TheStarsBlessing/TD4-CPU/原理图.pdf

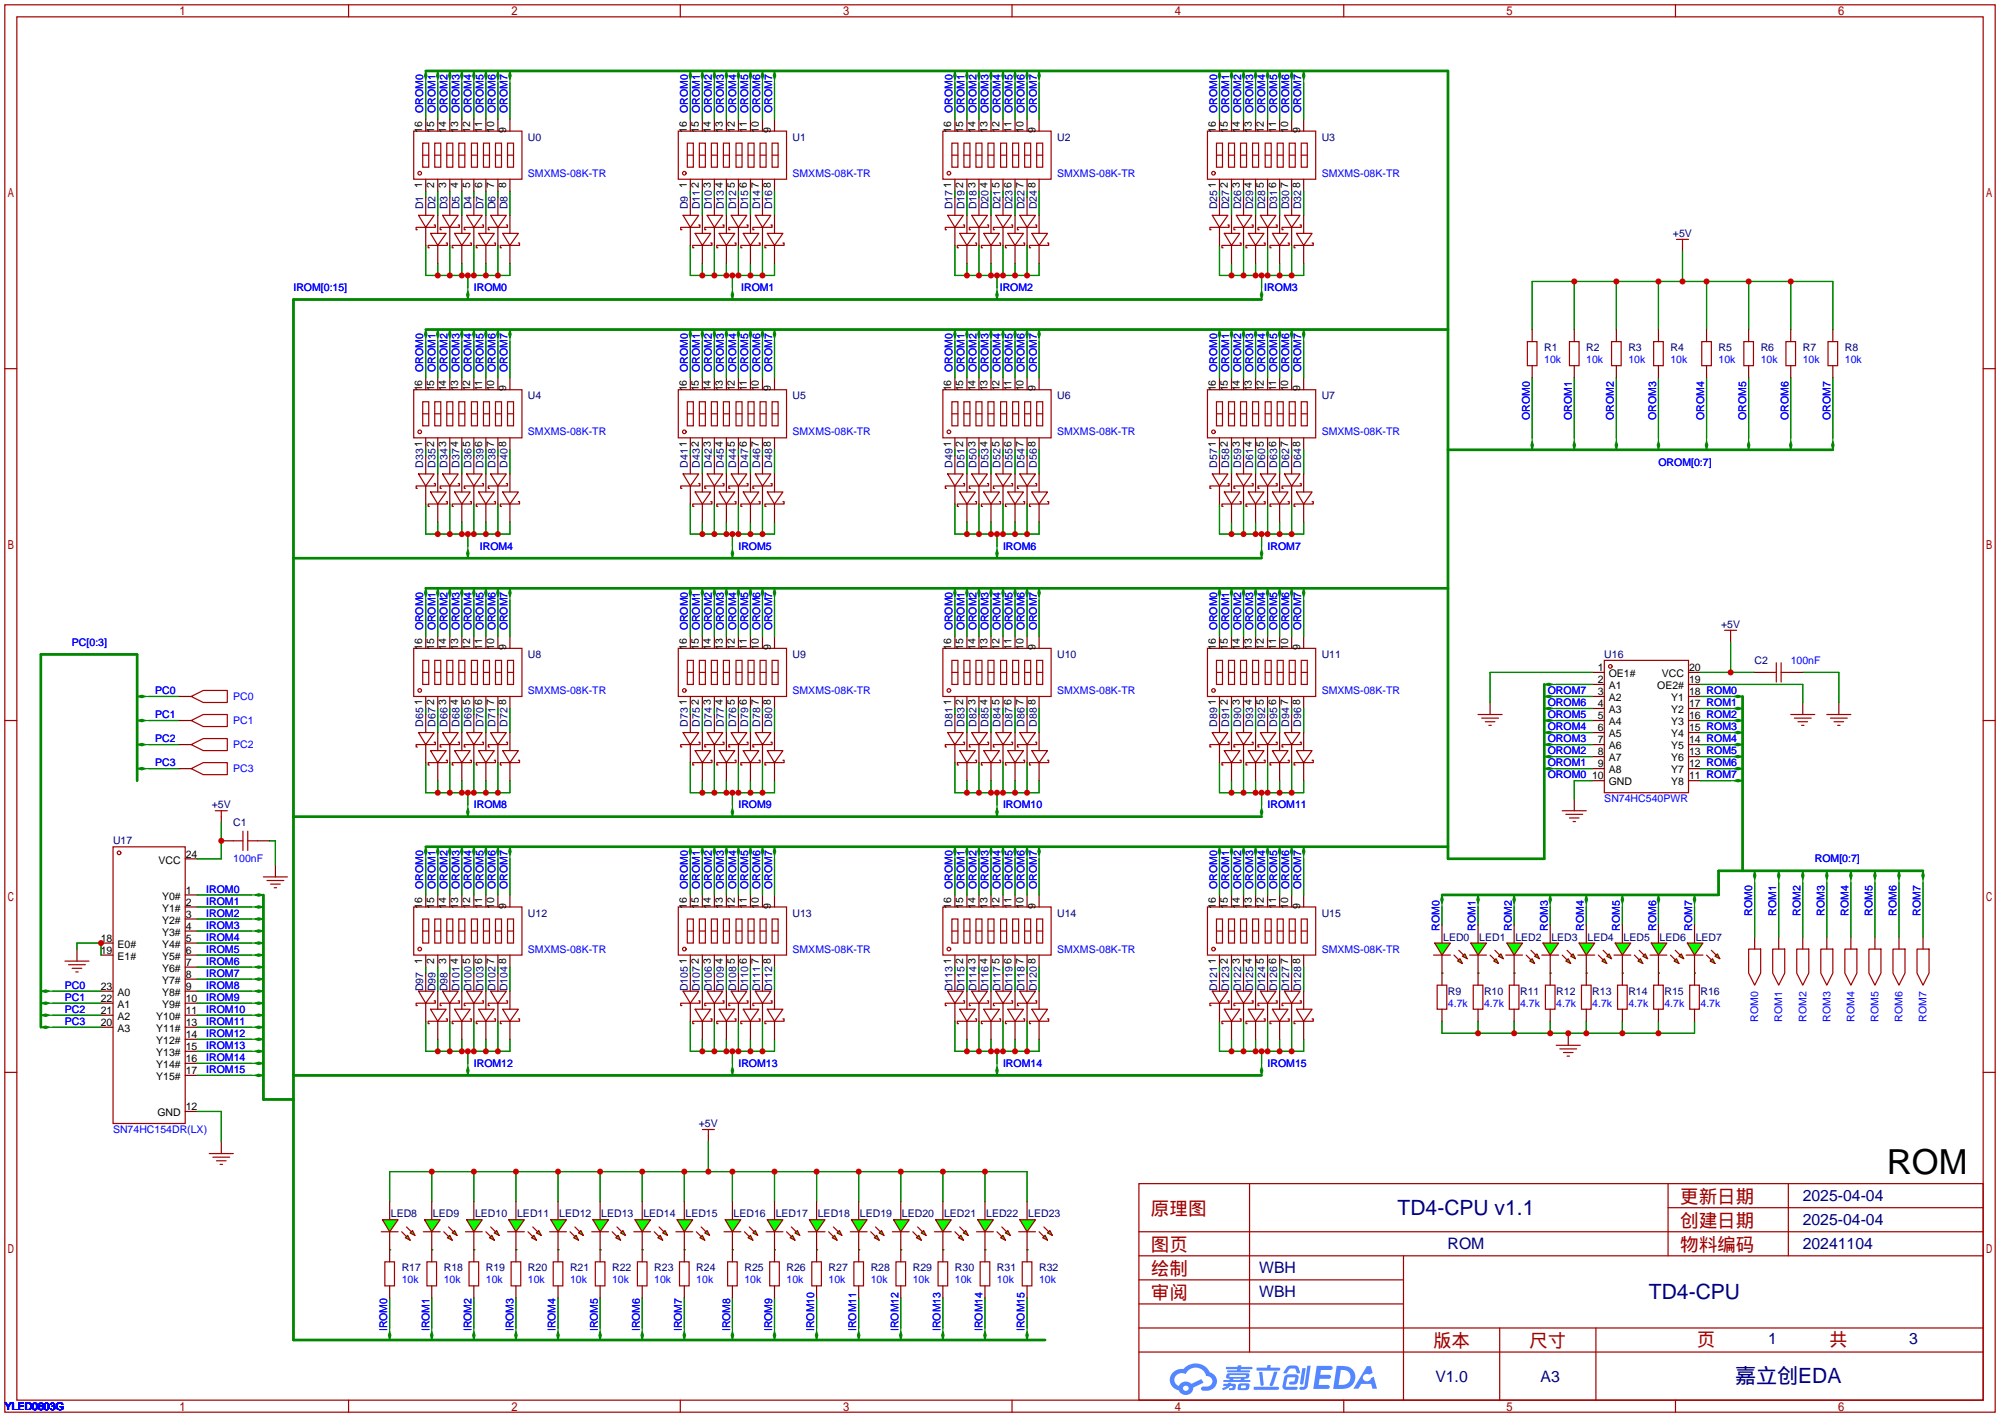
[picture p1: page 1]

# TE 10 Q3 11 Q2 12 Q1 13 Q0 14 TC 15 VCC 16

# reg_A

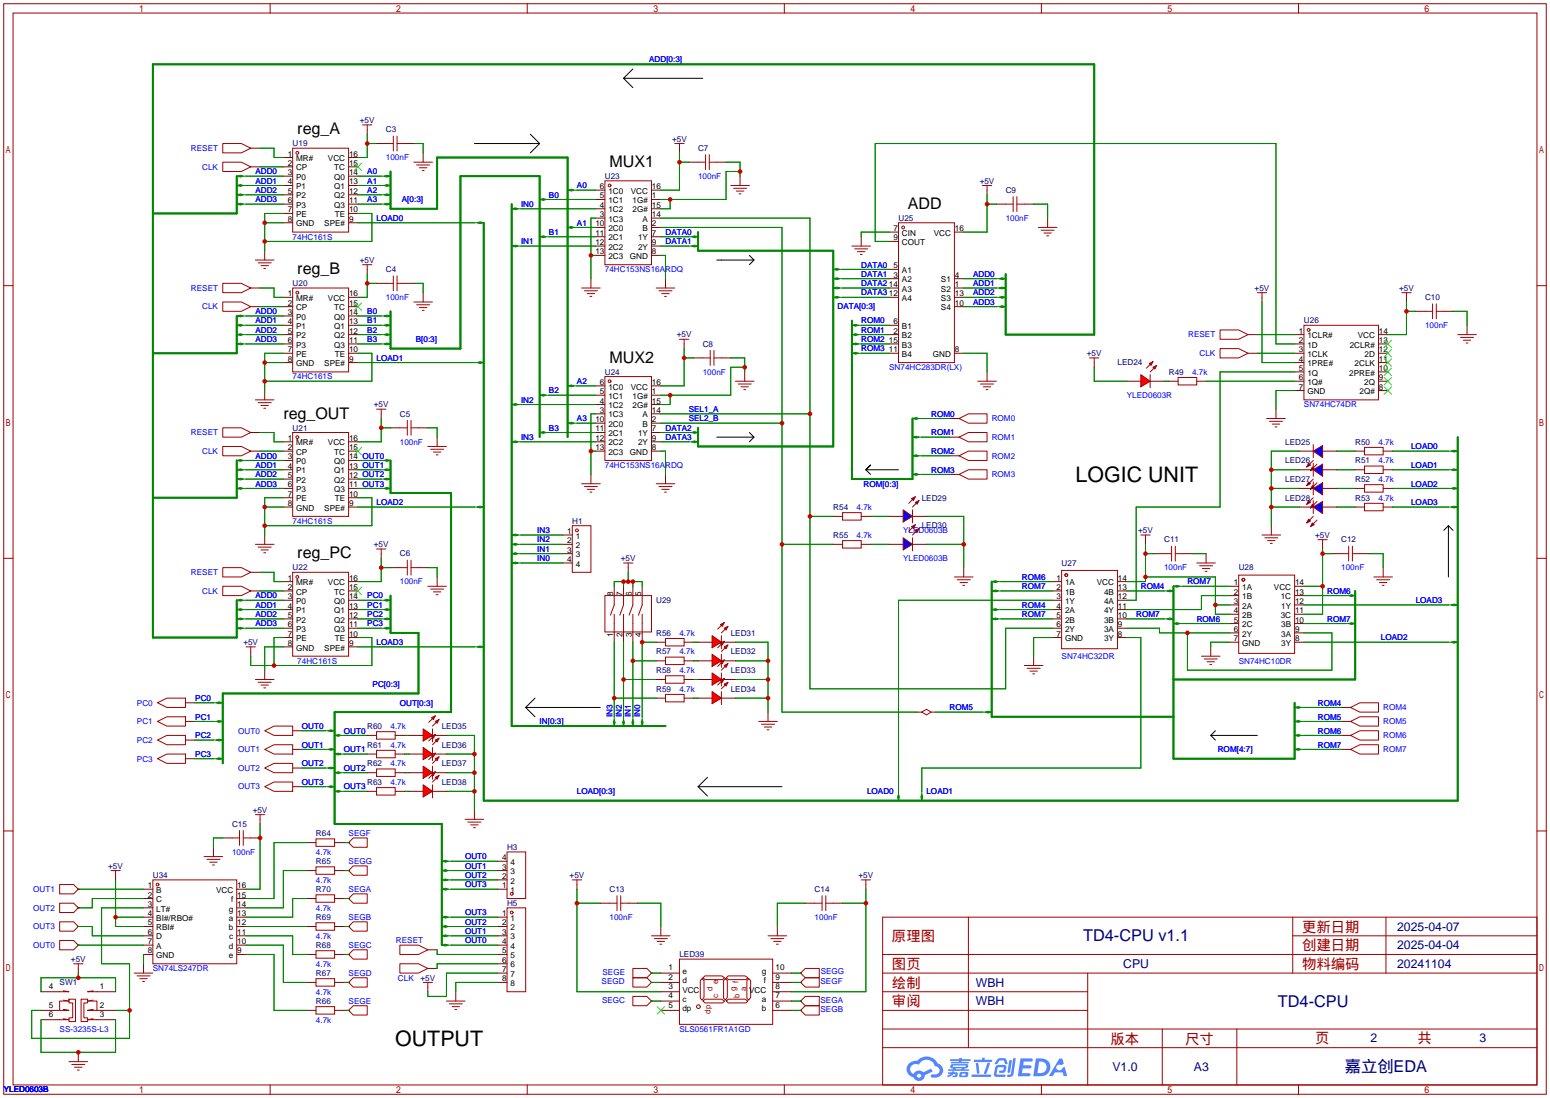
[picture p2: page 2]

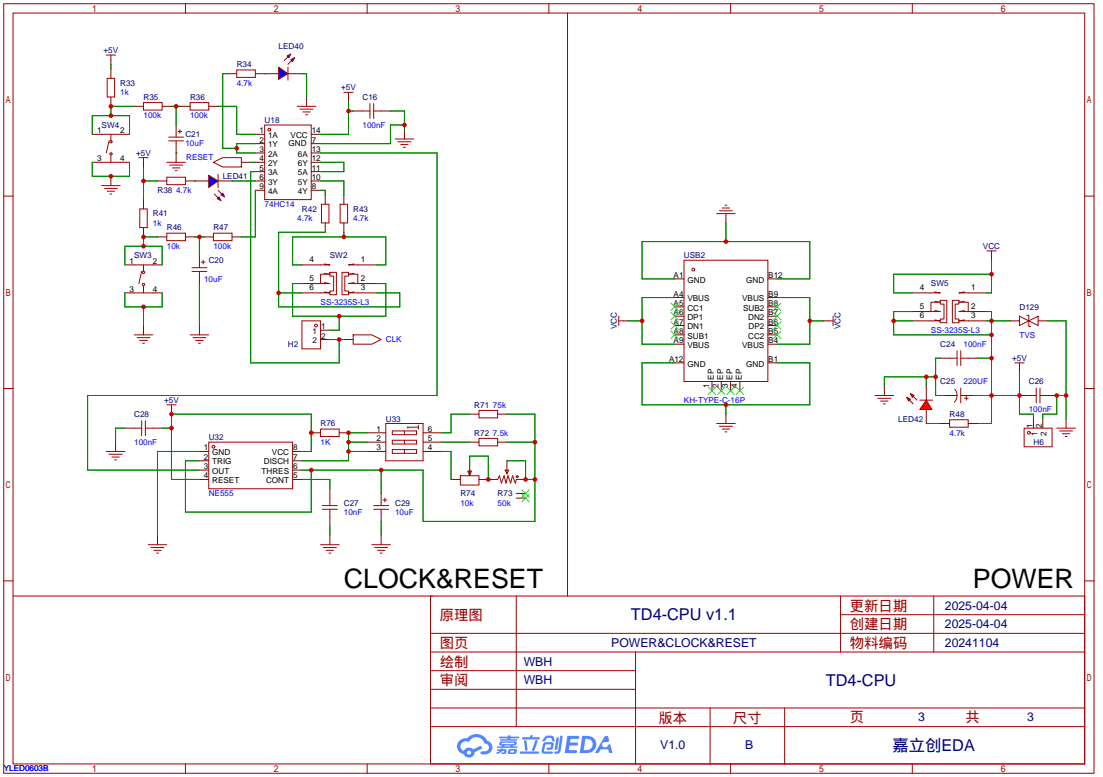
[picture p3: page 3]
