TheStarsBlessing/TD4-CPU/(list of files, drawings)

Other design files:
工程文件.epro
